elkayem/midi2cv/midi2cv.sch

## EAGLE design midi2cv.sch (2018-06-30)

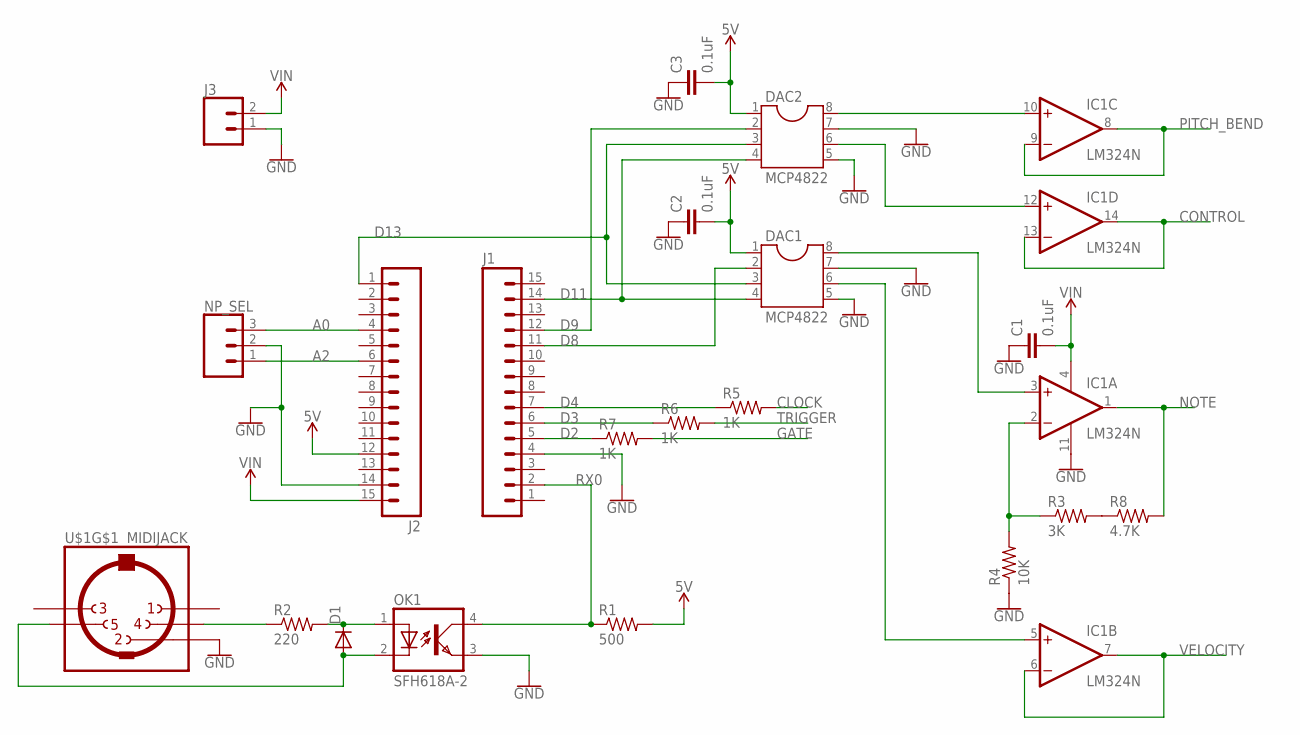
[picture p5: schematic midi2cv.sch]

Parts:
C1, C2, C3: 0.1uF; CAP-PTH-SMALL-KIT
D1: DIODE-D-10; D-10
DAC1, DAC2: MCP4822; SOCKET-08
IC1: LM324N; DIL14
J1, J2: M15; 1X15
J3: CONN_025MM; SCREWTERMINAL-5MM-2
NP_SEL: CONN_03; 1X03
OK1: SFH618A-2; DIP4
R1: 500; 0207/10
R2: 220; 0207/10
R3: 3K; 0207/10
R4: 10K; 0207/10
R5, R6, R7: 1K; 0207/10
R8: 4.7K; 0207/10
U$1: MIDIJACK; CP-2350

Connections:
5V: C2.2, C3.2, DAC1.1, DAC2.1, J2.12, R1.2
A0: J2.4, NP_SEL.3
A2: J2.6, NP_SEL.1
CLOCK: R5.2
CONTROL: IC1.13 (-IN), IC1.14 (OUT)
D2: J1.5, R7.1
D3: J1.6, R6.1
D4: J1.7, R5.1
D8: DAC1.2, J1.11
D9: DAC2.2, J1.12
D11: DAC1.4, DAC2.4, J1.14
D13: DAC1.3, DAC2.3, J2.1
GATE: R7.2
GND: C1.1, C2.1, C3.1, DAC1.5, DAC1.7, DAC2.5, DAC2.7, IC1.11 (V-), J1.4, J2.14, J3.1, NP_SEL.2, OK1.3 (EMIT), R4.1, U$1.2
unnamed: D1.C, OK1.1 (A), R2.2
unnamed: D1.A, OK1.2 (C), U$1.5
unnamed: R2.1, U$1.4
unnamed: DAC1.8, IC1.3 (+IN)
unnamed: R3.2, R8.1
unnamed: IC1.2 (-IN), R3.1, R4.2
unnamed: DAC1.6, IC1.5 (+IN)
unnamed: DAC2.8, IC1.10 (+IN)
unnamed: DAC2.6, IC1.12 (+IN)
NOTE: IC1.1 (OUT), R8.2
PITCH_BEND: IC1.8 (OUT), IC1.9 (-IN)
RX0: J1.2, OK1.4 (COL), R1.1
TRIGGER: R6.2
VELOCITY: IC1.6 (-IN), IC1.7 (OUT)
VIN: C1.2, IC1.4 (V+), J2.15, J3.2
