elkayem/midi2cv/(threads)

Thread 1 (2017-12-15):

banana jack to 3.5mm jack

dasmasdas, 2017-12-15:
I want to use this with 3.5mm jack but i want to make sure that I do. So can I replace it with 3.5mm jack in without changing anything?

elkayem, 2017-12-15:
Yes, you can do this.  In fact, this is a good way to connect the grounds if your midi to cv has a different power supply than whatever it is driving.

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

elkayem, 2017-12-15:
One more consideration...   With a 3.5mm jack, you will temporarily short the op amp output as you plug it in.  Some people like to put a current limiting resistor on the output to protect against this.   It isn't necessarily though if using the LM324 op amp, as the data sheet says the outputs can be shorted to ground indefinitely.   I might just go ahead and modify the schematic anyway, just to make it clear.

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

dasmasdas, 2017-12-16:
Thank you so much for this incredibly good information. I dont want to waste your time , its not necessary but if you have free time modify schematic but you dont have free time no problem. Thank you

Closed 2017-12-17.

Thread 2 (2018-02-22):

SPI out not working?

mccdam28, 2018-02-22:
I've built this project but don't seem to get any SPI out, MIDI goes in, SPI does not come out. Tested the SPI out separately and that works fine. Anything i'm missing? @elkayem

elkayem, 2018-03-09:
Did you ever figure out this problem?  Several others have built this project with success, so I know the code works.  I know it can be difficult to debug without access to the serial lines, which are tied up for MIDI communication.  I often set up another arduino as an SPI slave using Nick Gammon's SPI Slave code, and output debugging messages over the serial port that way.  See his Master/Slave example about a third of the way down: http://www.gammon.com.au/spi

mccdam28, 2018-03-10:
will give this ago, it seems midi comes in but no SPI comes out. Will get back to it this weekend.

CharlesV55, 2018-05-09:
Hi, I'm experiencing the same issue on SPI Out.
In the code, you didn't declare D13 & D11, connected to pin 3 & 4 of DAC's. Is it on purpose?

elkayem, 2018-05-09:
Pins 11 and 13 are the SPI MOSI and CLK for the nano and are already declared in the SPI library.

A few questions...  have you looked at the SPI signals on a scope and confirmed they aren’t working?   Are your wires short?  Could the issue be with your midi in instead?   Have you disconnected from your computer when using?

Let me know the results of your troubleshooting efforts.   Others have also successfully used this code, but it is always possible something changes in one of the libraries that breaks things.

Larry

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

CharlesV55, 2018-05-09:
Hi, Larry,
Thanks for answering.
Stupid me, pin 11 & 13 are effectively used by SPI!
Unfortunately, there is no SPI-out on the scope, and no SPI-clock either.
I'm disconnected from computer, device is on a PCB, 10Volts powered,
in order to be used on my MiniMoog Model D.
Libraries size I use:
Midi.h > 109KB
SPI.h > 309KB
Perhaps a Library issue, as you mentionned?
My Arduino Nano is a Chinese one, worked fine
with other Midi-to-something devices I made.
Regards

----- Mail original -----
De: "Larry McGovern" <notifications@github.com>
À: "elkayem/midi2cv" <midi2cv@noreply.github.com>
Cc: "CharlesV55" <charles.rangheard@free.fr>, "Comment" <comment@noreply.github.com>
Envoyé: Mercredi 9 Mai 2018 15:28:01
Objet: Re: [elkayem/midi2cv] SPI out not working? (#2)

Pins 11 and 13 are the SPI MOSI and CLK for the nano and are already declared in the SPI library.

A few questions... have you looked at the SPI signals on a scope and confirmed they aren’t working? Are your wires short? Could the issue be with your midi in instead? Have you disconnected from your computer when using?

Let me know the results of your troubleshooting efforts. Others have also successfully used this code, but it is always possible something changes in one of the libraries that breaks things.

Larry

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

—
You are receiving this because you commented.
Reply to this email directly, view it on GitHub , or mute the thread .

elkayem, 2018-05-09:
Is there anything on pin 2 coming from midi? Do the chip select pins 8 and 9 ever go low? It could be a problem with the midi signal, or the midi messages might not be interpreted correctly.   The midi library worked in my case but maybe something changed.  I’ve used a lot of Chinese nano clones and they either work completely or not at all.

Larry

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

CharlesV55, 2018-05-11:
Hi,
Midi signal is present on N°2 Tx pin, the Led flashes,
and on the scope the signal goes correctly from +5V to 0V.
Pin 8 & 9 are High and never go low.
Is it supposed to generate a clock signal on pin 13?

I've used the same Midi-in circuit on several Midi-to-Yamaha
mixing consoles controls I made, no problem.
I use MidiOx to generate Midi notes on channel 1, already used
with other Midi interfaces to test them, no problem, so far.

I've ordered some other Arduino Nano clones on Ebay, perhaps
this will solve the issue, cross fingers!
By the way, congrat's for your job.

----- Mail original -----
De: "Larry McGovern" <notifications@github.com>
À: "elkayem/midi2cv" <midi2cv@noreply.github.com>
Cc: "CharlesV55" <charles.rangheard@free.fr>, "Comment" <comment@noreply.github.com>
Envoyé: Mercredi 9 Mai 2018 16:47:58
Objet: Re: [elkayem/midi2cv] SPI out not working? (#2)

Is there anything on pin 2 coming from midi? Do the chip select pins 8 and 9 ever go low? It could be a problem with the midi signal, or the midi messages might not be interpreted correctly. The midi library worked in my case but maybe something changed. I’ve used a lot of Chinese nano clones and they either work completely or not at all.

Larry

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

—
You are receiving this because you commented.
Reply to this email directly, view it on GitHub , or mute the thread .

CharlesV55, 2018-05-15:
Hi, Larry,
I've found the problem:
The Tx signal must been pulled up to the +5V with a 1 KOhms resistance
instead of  512 Ohms, due to my 4N35 opto.
It works perfectly, now.
Thanks again.

elkayem, 2018-05-26:
I am going to close this issue, as I do not believe there is a problem with the SPI out in this code.  As CharlesV55 posted, check your optocoupler datasheet if you are using a different one that I have posted.  For example, the 4N35 optocoupler CharlesV55 used had a 30 - 40 usec high to low switch time when using a 500 ohm resistor, which is likely to slow for the 31.25 kbps MIDI rate (32 usec/bit).  Switching to a 1 k resistor reduced the switch time to 20 usec, which appears to be sufficient for his case.  Alternatively, the SFH618A optocoupler I use has < 10 usec switch time, and has not given me any problems with MIDI communication.

Closed 2018-05-26.

Thread 3 (2018-06-22):

clock starting in between beats

schmynth, 2018-06-22:
I experienced a glitch when starting the clock of a DAW, the Midi2CV module sometimes started a clock cycle somewhat in between to quarter notes. I thought this might be happening because of the clock_count not being reset when stopping the Midi_in Clock signal. A timeout variable solved this for me by editing the case midi::Clock Block as follows:

      case midi::Clock:
        if (millis() > timeout + 300) //prevents Clock from starting in between quarter Notes!
        {
          clock_count = 0;
        }
        timeout = millis();
        if (clock_count == 0) {
        // Start clock pulse
        digitalWrite(CLOCK,HIGH);
        clock_timer=millis();
        }
        clock_count++;
        if (clock_count == 12) {  // MIDI timing clock sends 24 pulses per quarter note.  send pulse every 12 pulses
          clock_count = 0;
        }
      case midi::ActiveSensing:
        break;
      default:
        d1 = MIDI.getData1();
        d2 = MIDI.getData2();
    }
    t = millis();
  }

schmynth, 2018-06-22:
I am new to github, so if I submitted this at the wrong place or in an odd way, please tell me, thanks!

elkayem, 2018-06-22:
Clever, thanks!   I agree, this will resync the clock pulses if they stop, for example, when restarting your DAW.  I will fold in this improvement when I get a moment.

elkayem, 2018-06-29:
I just added your change.  Good suggestion!  I'm closing this issue.

Closed 2018-06-29.

Thread 4 (2018-07-03):

midi2cv.sch is corrupt

davidcool, 2018-07-03:
Hello!
First, I LOVE this project... When I downloaded a clone the midi2cv.sch Eagle file was corrupt. Is it possible to update w/ a fixed version? Did you ever create a PCB for this?

davidcool, 2018-07-03:
I updated to newest Eagle version and this problem was fixed!

elkayem, 2018-07-04:
Glad you figured this out!   Also, to answer your first question, I did not create a PCs for this.  The circuit is simple enough that I just soldered it to a strip board.

Closed 2018-07-03.

Thread 5 (2018-11-01):

Solder Arduino Outputs directly to CV Ins

BLACKAVID, 2018-11-01:
Yo I just found your project here!
Firstly thank you for this amazing code & instruction.
I'm also building a MFOS. Do you need to use these CV Outputs from your Panel to make a connection to the desired CV input on the "main panel"?
I would rather make it with some On/ Off switches to activate/ deactivate the function to the soldered CV Inputs. Because the labels you made on your own Panel seem to only be connected to one certain Type of CV-Input. For that you could also solder it right on the CV right or am I wrong?

Greetz

elkayem, 2019-03-29:
Sorry, Just saw this note even though it is months old. Yes, you can solder internally and use switches as you suggest.  Just make sure your circuit and the MFOS share a common ground.

Closed 2019-03-29.

Thread 6 (2019-03-28):

Power

Kooza25, 2019-03-28:
Hello there! How can i convert eurorack 12v power to 5 for arduino?
Is it a nano?

elkayem, 2019-03-29:
You only need to supply 12v. The nano has its own 5v regulator.

Closed 2019-03-29.

Thread 7 (2019-04-10):

1K resistors on gate outputs

aluedt, 2019-04-10:
Hi,

thanks for this nice project. Just a simple question from a beginner. Why these 1K resistors on the gate outputs? Shouldn't these be 5V anyway?

Thanks
--Andree

mikenye, 2019-04-11:
Likely for current limiting. If the outputs are accidentally shorted to ground, the 1K resistor protects the circuit from overload and damage.

elkayem, 2020-01-26:
Sorry for the delay, closing old issues. The 1K resistors are indeed to protect against excessive current.

Closed 2020-01-26.

Thread 8 (2019-08-19):

midi2cv with protools

nickmina, 2019-08-19:
I successfully made the midi2cv with arduino nano and works perfectly with my Arturia KeyLab61 master keyboard but connected to a midi interface controlled by Protools does not work.
Do you have any suggestions?
Thank you.
Nicola

CharlesV55, 2019-08-19:
Hi,
please describe your installation:
which version of Protools/OSX
which Midi interface do you use between PT and Midi2CV
Which equipement do you drive with Mid2CV
Can you monitor Midi output (led or something)
Maybe Ptools Midi protocol is different from standard Midi. Check!

----- Mail original -----
De: "nickmina" <notifications@github.com>
À: "elkayem/midi2cv" <midi2cv@noreply.github.com>
Cc: "Subscribed" <subscribed@noreply.github.com>
Envoyé: Lundi 19 Août 2019 12:20:59
Objet: [elkayem/midi2cv] midi2cv with protools (#8)

I successfully made the midi2cv with arduino nano and works perfectly with my Arturia KeyLab61 master keyboard but connected to a midi interface controlled by Protools does not work.
Do you have any suggestions?
Thank you.
Nicola

—
You are receiving this because you are subscribed to this thread.
Reply to this email directly, view it on GitHub , or mute the thread .

nickmina, 2019-08-19:
Hi,
the version of Protools is the latest 2019.6.0.
I tried the midi interface integrated into the RME Fireface 400 sound card and the Roland UM-2ex midi interface and the result is the same.
I inserted a led on the midi input of the mi2cv to check the activity and everything seems to work.
Thanks

nickmina, 2019-08-19:
I meant "the midi entry seems to work"

nickmina, 2019-08-19:
Hi,
I solved the problem!
It was enough to replace the 6FH618A-2 optocoupler with a more performing model like the 6N138 and it all worked out.
Thanks

elkayem, 2020-01-26:
Glad issue was solved, closing this issue.

Closed 2020-01-26.

Thread 9 (2019-10-24):

USBMIDI version

66hertz, 2019-10-24:
Hello! I was able to build your MIDI2CV device, thanks for the code! But i also was always hoping to do it with MidiUSB. Few days ago i started to change code in order to make it work with USB.
First of all i decided to test **gate**, **trig** and **clock** outputs. Clock and trigger works fine, but **gate**.. Can you please take a look and maybe see what's going on with it?
Behaviour: When you press a note for the first time, **gate** pin goes high. But it won't turn off when note is released. Also, if you press random notes 20 times, **gate** pin turns off and gives small peaks of voltage every next time you press a note. I think the problem is in "CommandLastNote" function (i only use this one), it has i<20 in for cycle.   I am noob in programming, expecially in C++.
Oh, by the way, i am using Arduino Pro Micro.

Here is the code, as you can see i deleted many things (2nd DAC, note priority selection) as i don't need it. I will be greatful for any advice!

```
#include "MIDIUSB.h"
#include <SPI.h>

#define GATE  5
#define TRIG  6
#define CLOCK 4
#define DAC1  8

void setup()
{
 pinMode(GATE, OUTPUT);
 pinMode(TRIG, OUTPUT);
 pinMode(CLOCK, OUTPUT);
 pinMode(DAC1, OUTPUT);
 digitalWrite(GATE,LOW);
 digitalWrite(TRIG,LOW);
 digitalWrite(CLOCK,LOW);
 digitalWrite(DAC1,HIGH);

 SPI.begin();

 Serial.begin(115200);
}

bool notes[88] = {0};
int8_t noteOrder[20] = {0}, orderIndx = {0};
unsigned long trigTimer = 0;

void loop()
{
  int noteMsg, velocity, channel;
  static unsigned long clock_timer=0, clock_timeout=0;
  static unsigned int clock_count=0;

  if ((trigTimer > 0) && (millis() - trigTimer > 20)) {
    digitalWrite(TRIG,LOW); // Set trigger low after 20 msec
    trigTimer = 0;
  }

  if ((clock_timer > 0) && (millis() - clock_timer > 20)) {
    digitalWrite(CLOCK,LOW); // Set clock pulse low after 20 msec
    clock_timer = 0;
  }

  midiEventPacket_t rx = MidiUSB.read();  //listen for new MIDI messages
  switch (rx.byte1) {
    case 0x90:            //Note On message channel 1
      noteMsg = rx.byte2 - 21; // A0 = 21, Top Note = 108
	    if ((noteMsg < 0) || (noteMsg > 87)) break;
	    velocity = rx.byte3;
      if (velocity == 0)  {
        notes[noteMsg] = false;
      }
      else {
        notes[noteMsg] = true;
          // velocity range from 0 to 4095 mV  Left shift d2 by 5 to scale from 0 to 4095,
          // and choose gain = 2X
        setVoltage(DAC1, 1, 1, velocity<<5);  // DAC1, channel 1, gain = 2X
      }
      if (notes[noteMsg]) {  // If note is on and using last note priority, add to ordered list
        orderIndx = (orderIndx+1) % 20;
        noteOrder[orderIndx] = noteMsg;         
        }
      commandLastNote();

    case 0xF8:      //Clock
      if (millis() > clock_timeout + 300) clock_count = 0; // Prevents Clock from starting in between quarter notes after clock is restarted!
      clock_timeout = millis();

      if (clock_count == 0) {
        digitalWrite(CLOCK,HIGH); // Start clock pulse
        clock_timer = millis();
      }
      clock_count++;
      if (clock_count == 24) {  // MIDI timing clock sends 24 pulses per quarter note.  Sent pulse only once every 24 pulses
        clock_count = 0;
      }
      break;
  }
}

void commandLastNote()
{

  int8_t noteIndx;

  for (int i=0; i<20; i++) {
    noteIndx = noteOrder[ mod(orderIndx-i, 20) ];
    if (notes[noteIndx])
      commandNote(noteIndx);
    else
      return;

  }
  digitalWrite(GATE,LOW);  // All notes are off
}

#define NOTE_SF 47.069f // This value can be tuned if CV output isn't exactly 1V/octave

void commandNote(int noteMsg) {
  digitalWrite(GATE,HIGH);
  digitalWrite(TRIG,HIGH);
  trigTimer = millis();

  unsigned int mV = (unsigned int) ((float) noteMsg * NOTE_SF + 0.5);
  setVoltage(DAC1, 0, 1, mV);  // DAC1, channel 0, gain = 2X
}

void setVoltage(int dacpin, bool channel, bool gain, unsigned int mV)
{
  unsigned int command = channel ? 0x9000 : 0x1000;

  command |= gain ? 0x0000 : 0x2000;
  command |= (mV & 0x0FFF);

  SPI.beginTransaction(SPISettings(8000000, MSBFIRST, SPI_MODE0));
  digitalWrite(dacpin,LOW);
  SPI.transfer(command>>8);
  SPI.transfer(command&0xFF);
  digitalWrite(dacpin,HIGH);
  SPI.endTransaction();
}

int mod(int a, int b)
{
    int r = a % b;
    return r < 0 ? r + b : r;
}
```

66hertz, 2019-10-24:
PS: Ok, i was able to turn gate off by adding
```
case 0x80:
  digitalWrite(GATE,LOW);
```
But it still goes nuts after 20 notes pressed.

thwop, 2019-10-24:
I haven't got time to fully go through your code, but it sounds like you
might be going outside the array.

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

Closed 2020-01-26.

Thread 10 (2019-10-30):

Adapting the Project for 6-Voice Polyphony

orchestron, 2019-10-30:
Hi,

Great project.  How would you recommend adapting the code and schematics for 6-voice polyphony?

Cheers.

MoxorTheOne, 2019-11-05:
Im trying to do the same, or at least 4 voices, do you have a fork?

elkayem, 2020-01-26:
Just catching up on this old issues. You would need to have multiple channels and multiple DAC outputs. Take a look at my code [here](https://github.com/elkayem/usbMIDI2CV_MC), which outputs 3 channels.

Closed 2020-01-26.

Thread 11 (2019-11-07):

Pitch changes to Note output

GarryGNsk, 2019-11-07:
Hi From Siberia. I made this Project and its work great with my USSR POLIVOX SYNTH.
Is it possible to make code changes that makes pitch changes sand to note output?
when I turn pichwheel my note goes up ar down on 2 semitones.
Sorry for my English
Thanks.

elkayem, 2020-01-26:
You could add the note and the pitch bend together if that is what you want. Closing this one, since this isn't an issue with my code so much as a feature request.

Closed 2020-01-26.

Thread 12 (2019-12-10):

Protoboard component placement

philippejadin, 2019-12-10:
Thank you for this great project. By any chance, do you have the protoboard component placement?
Or a fritzing schema?
If not I'll try to make it and I will make a pull request.

elkayem, 2019-12-11:
No I don’t. There aren’t many components and fairly straight forward to lay out, so I didn’t bother.  If you do create something I can merge.

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

philippejadin, 2020-01-25:
and of course someone already made one, it is here and seems decent : https://www.reddit.com/r/synthdiy/comments/cqpecf/finally_an_updated_midicv_layout/

elkayem, 2020-01-26:
Very interesting, thank you for the link! I am a little reluctant to post this stripboard layout on this page as the author states "however I have not tested the other other outputs as of yet so cannot verify these." However, the link is here and should help others seeking guidance on a layout.

Closed 2020-01-26.

Thread 13 (2020-01-26):

Using software serial is unreliable

philippejadin, 2020-01-26:
Just for those trying to use software serial to connect a midi input, it is unreliable and not advised :
https://arduino.stackexchange.com/questions/38567/softwareserial-too-slow-for-midi

The problem I was trying to fix was that one cannot program the arduino if the optocoupler is connected to the RX pin. A somewhat nice fix would be to put a jumper that must be removed when you want to reprogram the arduino. (this is with an arduino clone with the ch340 driver, so maybe this would work fine with a genuine nano)

Or did I miss something?

elkayem, 2020-01-26:
Regarding SoftwareSerial... this code does not use it so I cannot see this is an issue for this code.

Addressing your second comment, agreed that you cannot program the nano while it is plugged into the board due to the 500 ohm optocoupler resistor pulling RX up to 5V. As a general practice on any board, I would recommend unplugging the nano before programming it. This is the easiest solution. A custom solution may be needed if your board is inaccessible.

Closed 2020-01-26.

Thread 15 (2020-05-05):

OP Amp connection to -12V

atulrnt, 2020-05-05:
Hi,

I'm currently building a modular synth and I'm going to use your module on it.

When reproducing the schematics, I've noticed that the -12V is not used anywhere.
Isn't it supposed to be connected to IC1A on pin 2 ?

Can you please clarify this point for me as I'm no expert in electronics but I'm slowly learning !

Thank you for sharing this project !

atulrnt, 2020-05-05:
My bad, I misread the readme...

Closed 2020-05-05.

Thread 16 (2021-01-25):

errors compiling

nickademus420, 2021-01-25:
Hi. I just tried to compile the code and got a ton of errors. Not sure what files or info you would need to help me, but if you can help, please let me know what info you need. Thanks.

elkayem, 2021-01-25:
You are probably using a newer version of the MIDI and SPI libraries than I used. I haven’t tried compiling in 2 years so I’m sure there have been some changes. I should probably take a look at some point. In the mean time, you can always try a version of those libraries from mid-2018.

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

nickademus420, 2021-01-25:
<!--
/* Font Definitions */
@font-face
	{font-family:"Cambria Math";
	panose-1:2 4 5 3 5 4 6 3 2 4;}
@font-face
	{font-family:Calibri;
	panose-1:2 15 5 2 2 2 4 3 2 4;}
/* Style Definitions */
p.MsoNormal, li.MsoNormal, div.MsoNormal
	{margin:0in;
	font-size:11.0pt;
	font-family:"Calibri",sans-serif;}
a:link, span.MsoHyperlink
	{mso-style-priority:99;
	color:blue;
	text-decoration:underline;}
.MsoChpDefault
	{mso-style-type:export-only;}
@page WordSection1
	{size:8.5in 11.0in;
	margin:1.0in 1.0in 1.0in 1.0in;}
div.WordSection1
	{page:WordSection1;}
-->Thanks for the reply. Somehow during the downloading of the files something got messed up on the .ino file. I simply copied the code off the website and replaced it in the file, compiled, and uploaded! Sorry to bother you, and thank you so much for your work! Now tomorrow I test my hardware to see if it works!Will MillerSent from Mail for Windows 10 From: Larry McGovernSent: Sunday, January 24, 2021 11:26 PMTo: elkayem/midi2cvCc: nickademus420; AuthorSubject: Re: [elkayem/midi2cv] errors compiling (#16) You are probably using a newer version of the MIDI and SPI libraries than I used. I haven’t tried compiling in 2 years so I’m sure there have been some changes. I should probably take a look at some point. In the mean time, you can always try a version of those libraries from mid-2018. > On Jan 24, 2021, at 5:16 PM, nickademus420 <notifications@github.com> wrote:> >  > Hi. I just tried to compile the code and got a ton of errors. Not sure what files or info you would need to help me, but if you can help, please let me know what info you need. Thanks.> > —> You are receiving this because you are subscribed to this thread.> Reply to this email directly, view it on GitHub, or unsubscribe.—You are receiving this because you authored the thread.Reply to this email directly, view it on GitHub, or unsubscribe. 

brbrr, 2021-04-01:
Hi @elkayem
It is compiling in my case, but for some reason arduino is not reacting on midi input. When I comment out SPI.begin it start registering inputs. Any idea what might be wrong?

Closed 2021-08-04.

Thread 17 (2021-08-04):

missing digital out on 11 ?

ericbalcon, 2021-08-04:
Hi, I'm just looking at  your schematics and noticed that D11 is connected to the MCPs, but in your code I can't see where the digital 11 is programmed. all the others it's clear but this one ? did I miss something  ? regards

elkayem, 2021-08-04:
It’s the SPI data pin.

ericbalcon, 2021-08-04:
Thanks for your reply . Yes, I had a look to the MCPs datasheet but I was asking why you didn't declare the output 11 in your code.

Closed 2021-08-04.

Thread 18 (2023-11-18):

Don't wire MIDI pin 2 to ground

allisonkarlitskaya, 2023-11-18:
[The current version of the schematic](https://github.com/elkayem/midi2cv/blob/1626113092650d5b7fb3bcff1e6b570a65b09d46/images/schematic.JPG) shows pin 2 of the MIDI input wired to ground.  This violates the intended principle of galvanic isolation and can cause ground loops, since the "MIDI out" port of the connected device *will* connect this pin through to ground on its side.  If both devices are connected to mains ground, the loop results.

See https://en.wikipedia.org/wiki/MIDI#Electrical_specifications (with included schematic):

> The MIDI specification provides for a ground "wire" and a braid or foil shield, connected on pin 2, protecting the two signal-carrying conductors on pins 4 and 5. Although the MIDI cable is supposed to connect pin 2 and the braid or foil shield to chassis ground, it should do so only at the MIDI out port; the MIDI in port should leave pin 2 unconnected and isolated.  Some large manufacturers of MIDI devices use modified MIDI in-only DIN 5-pin sockets with the metallic conductors intentionally omitted at pin positions 1, 2, and 3 so that the maximum voltage isolation is obtained.

The original MIDI specification itself does offer an "optional" 0.1µF capacitor on the receiving side "to improve RF grounding", but otherwise also specifies no connection:

https://web.archive.org/web/20151222120442/http://www.midi.org/techspecs/ca33.pdf

In any case, a direct connection to ground is definitely problematic.

bespokecomp, 2024-04-24:
Hi. I built a circuit very closely based on this. I tried with ground connection on the midi input and can't get my device to convert midi to CV.
I disconnected ground on the midi input and still I can't get it to work.
any ideas or tips that could help?
Many thanks

htor, 2024-09-03:
Good information, thanks! I left the MIDI GND disconnected on my unit. Works fine.

Thread 19 (2025-07-15):

Not Getting full range of notes

tonyhucks, 2025-07-15:
Everything is working as such but with regards to the notes output I am not getting a full 88 notes CV range. I am only getting about two octaves of actual range. I can get a higher CV voltage with a higher key but as soon as I release the key the voltage drops back down. Any thoughts?

tonyhucks, 2025-07-15:
OK sorry, my fault. I hadn't used 12V for the op amp, only 5V.
