elkayem/midi2cv/(commit log)

2017-10-25 Update schematic with buffers on all DAC outputs
    [midi2cv.sch]
2017-12-08 Fix issue if MIDI returns note outside 88 key range.
    [midi2cv.ino]
2018-06-30 Added note priority setting
    [midi2cv.sch]
